theinsideshine/simply-supported-beam/docs/simply_supported_beam_BOM_v1.01.pdf

### BOM agrupado por nombre de pieza - solo piezas terminales

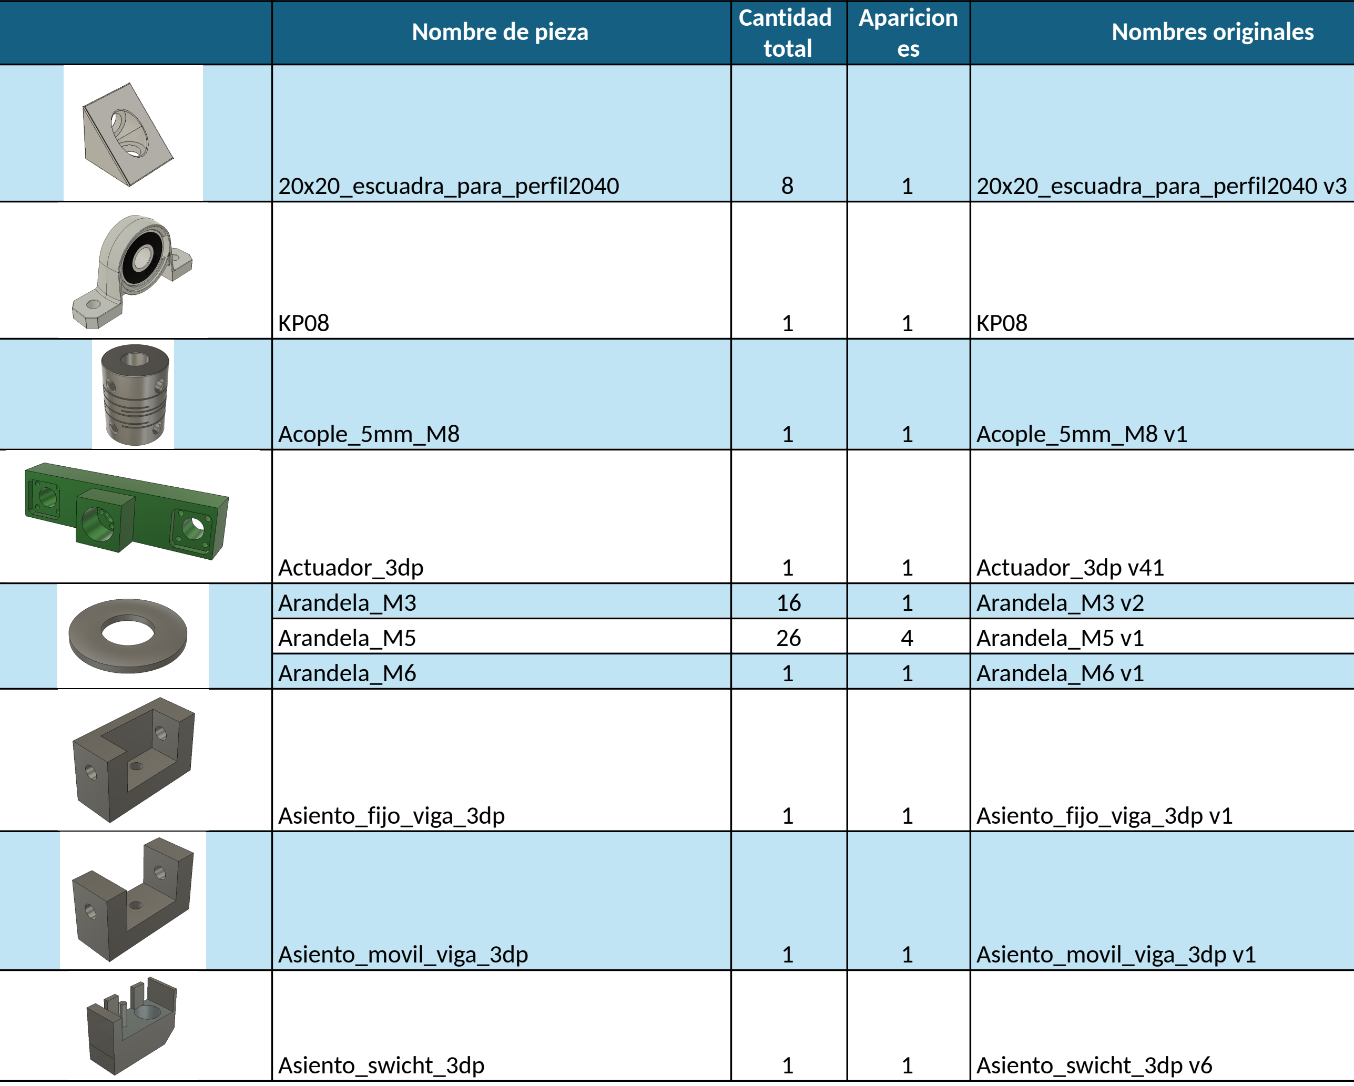
[picture p29: figure]
Nombre de pieza; Cantidad total; Aparicion es; Nombres originales; 20x20_escuadra_para_perfil2040; 20x20_escuadra_para_perfil2040 v3; Acople_5mm_M8; Acople_5mm_M8 v1; Actuador_3dp; Actuador_3dp v41; Arandela_M3; Arandela_M3 v2; Arandela_M5; Arandela_M5 v1; Arandela_M6; Arandela_M6 v1; Asiento_fijo_viga_3dp; Asiento_fijo_viga_3dp v1; Asiento_movil_viga_3dp; Asiento_movil_viga_3dp v1; Asiento_swicht_3dp; Asiento_swicht_3dp v6

Barra_thsl_M8_130mm-parteB | 1 | 1 | Barra_thsl_M8_130mm-parteB v1
Barra_thsl_M8_80mm-parteA | 1 | 1 | Barra_thsl_M8_80mm-parteA v1
Cama_pesas_3dp | 1 | 1 | Cama_pesas_3dp v4

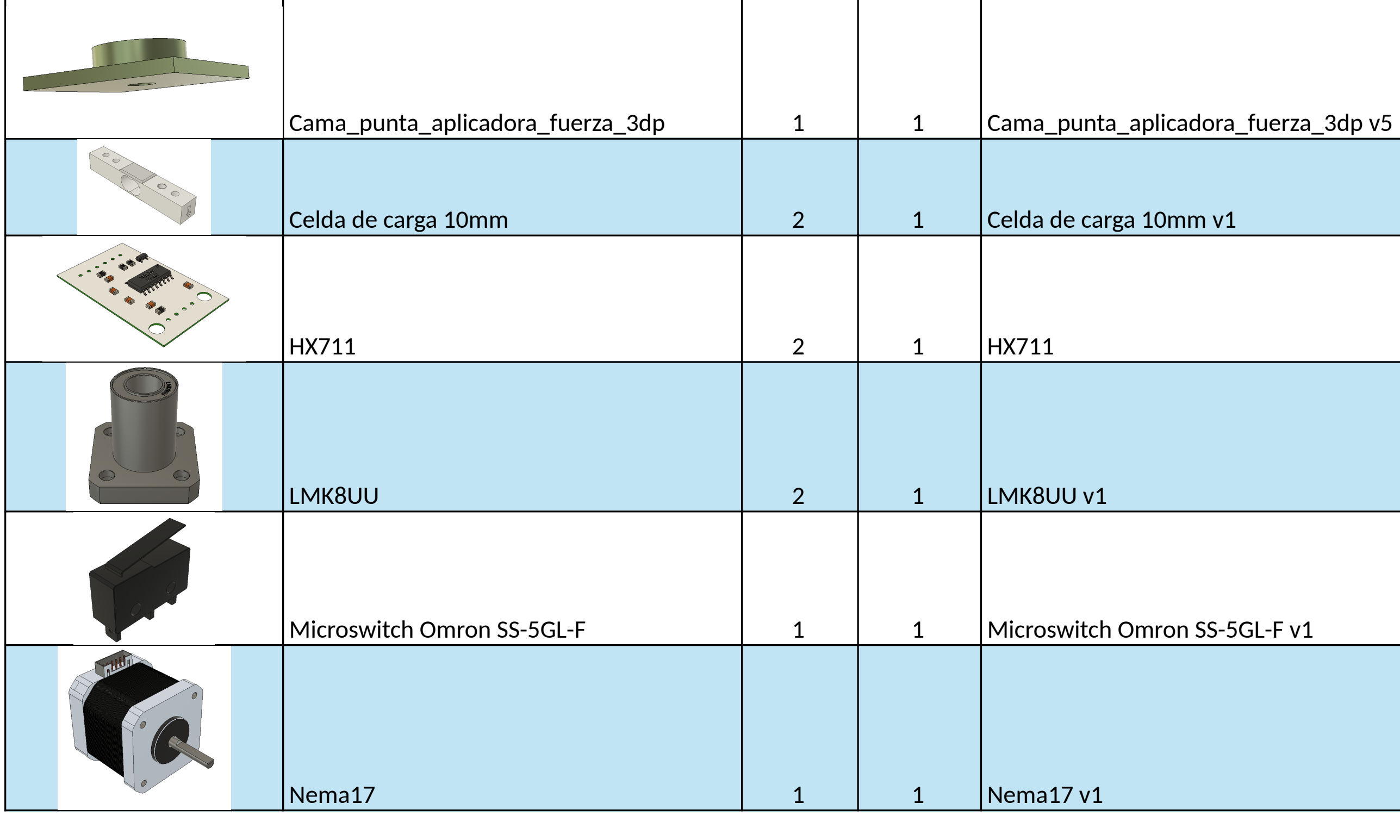
[picture p30: figure]
Cama_punta_aplicadora_fuerza_3dp; Cama_punta_aplicadora_fuerza_3dp v5; Celda de carga 10mm; Celda de carga 10mm v1; LMK8UU; LMK8UU v1; Microswitch Omron SS-5GL-F; Microswitch Omron SS-5GL-F v1; Nema17; Nema17 v1

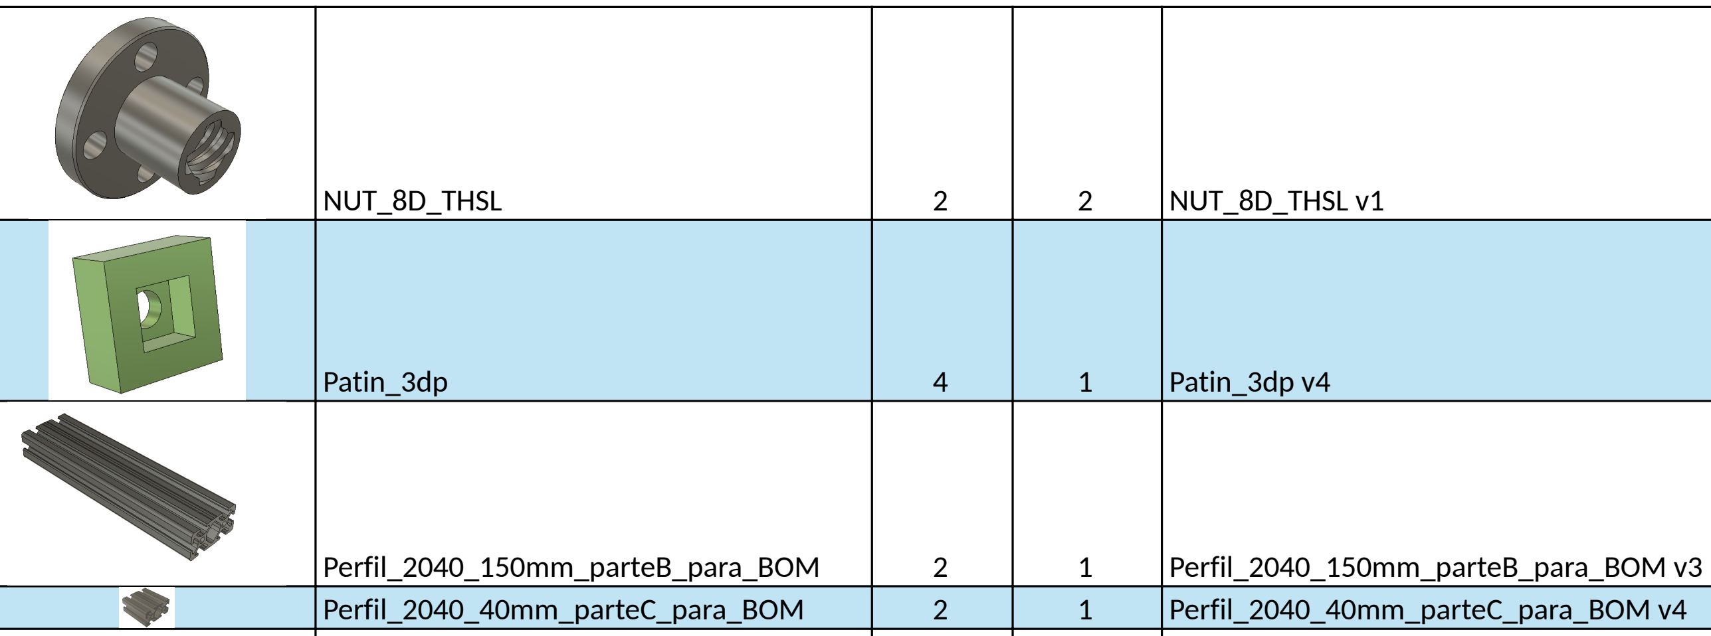
[picture p31: figure]
NUT_8D_THSL; NUT_8D_THSL v1; Patin_3dp; Patin_3dp v4; Perfil_2040_150mm_parteB_para_BOM; Perfil_2040_150mm_parteB_para_BOM v3; Perfil_2040_40mm_parteC_para_BOM; Perfil_2040_40mm_parteC_para_BOM v4
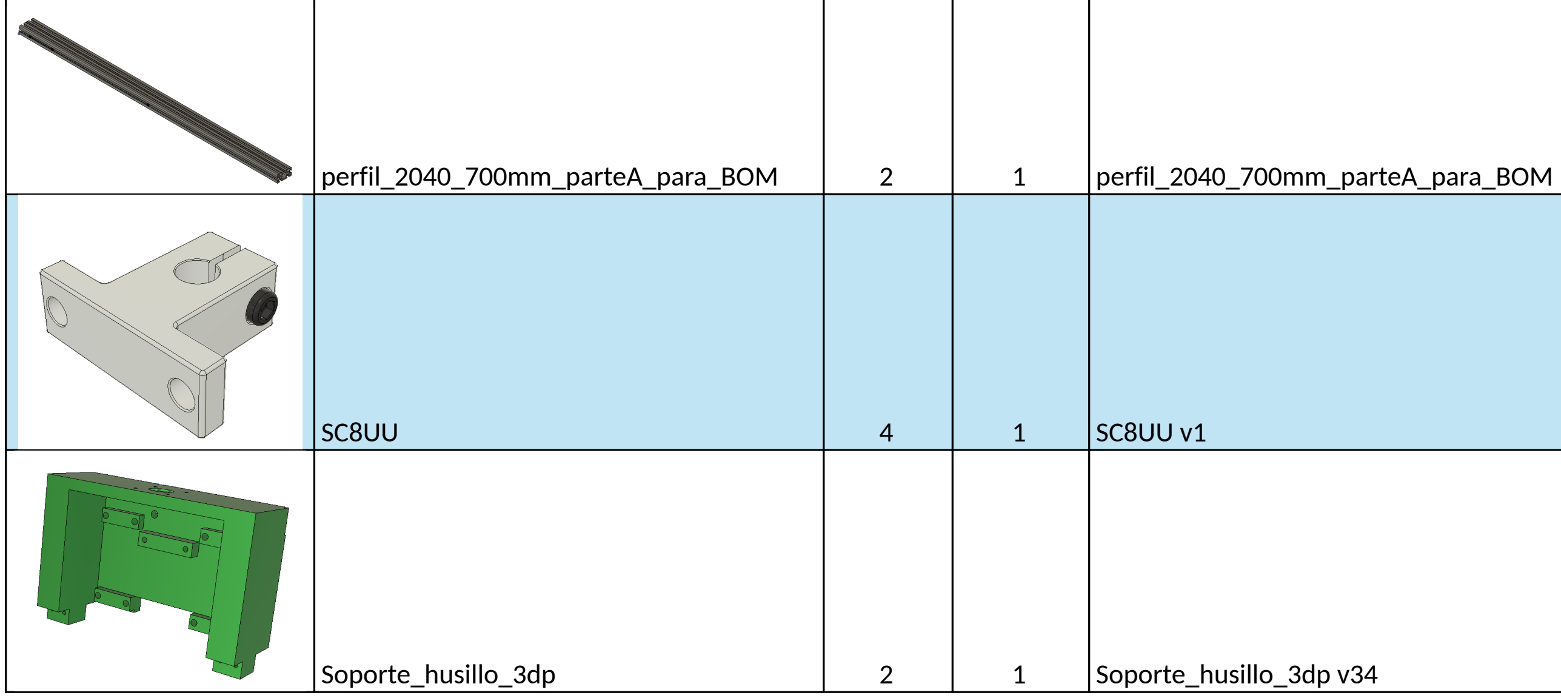
[picture p32: figure]
perfil_2040_700mm_parteA_para_BOM; Soporte_husillo_3dp; Soporte_husillo_3dp v34

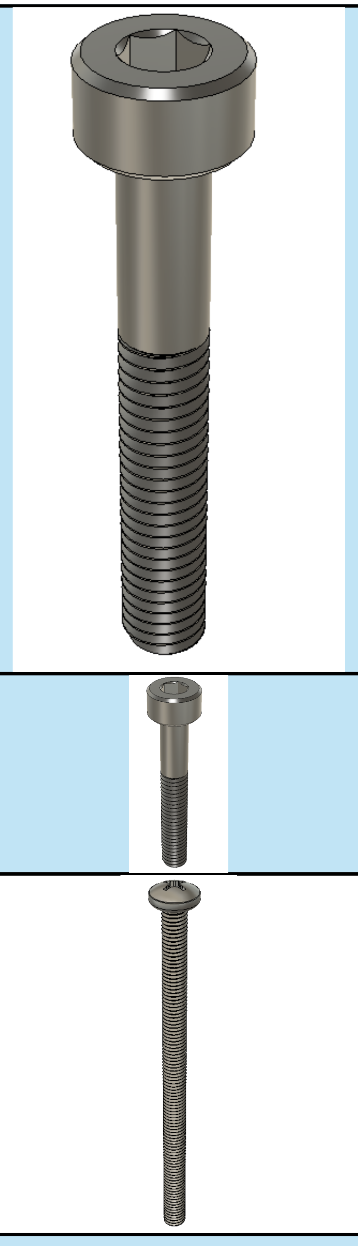
[picture p33: figure]

Tornillo_allen_M3_20mm | 4 | 1 | Tornillo_allen_M3_20mm v1
Tornillo_allen_M3_30mm | 12 | 1 | Tornillo_allen_M3_30mm v1
Tornillo_allen_M3_40mm | 8 | 1 | Tornillo_allen_M3_40mm v1
Tornillo_allen_M4_20mm | 2 | 1 | Tornillo_allen_M4_20mm v1
Tornillo_allen_M4_35mm | 1 | 1 | Tornillo_allen_M4_35mm v1
Tornillo_allen_M4_45mm | 1 | 1 | Tornillo_allen_M4_45mm v1
Tornillo_allen_M5_10mm | 20 | 2 | Tornillo_allen_M5_10mm v1
Tornillo_allen_M5_15mm | 2 | 2 | Tornillo_allen_M5_15mm v1
Tornillo_allen_M5_30mm | 16 | 1 | Tornillo_allen_M5_30mm v1
| Tornillo_allen_M5_50mm | 8 | 1 | Tornillo_allen_M5_50mm v1
| Tornillo_allen_M6_15mm | 1 | 1 | Tornillo_allen_M6_15mm v1
| Tornillo_allen_M6_55mm | 2 | 2 | Tornillo_allen_M6_55mm v1

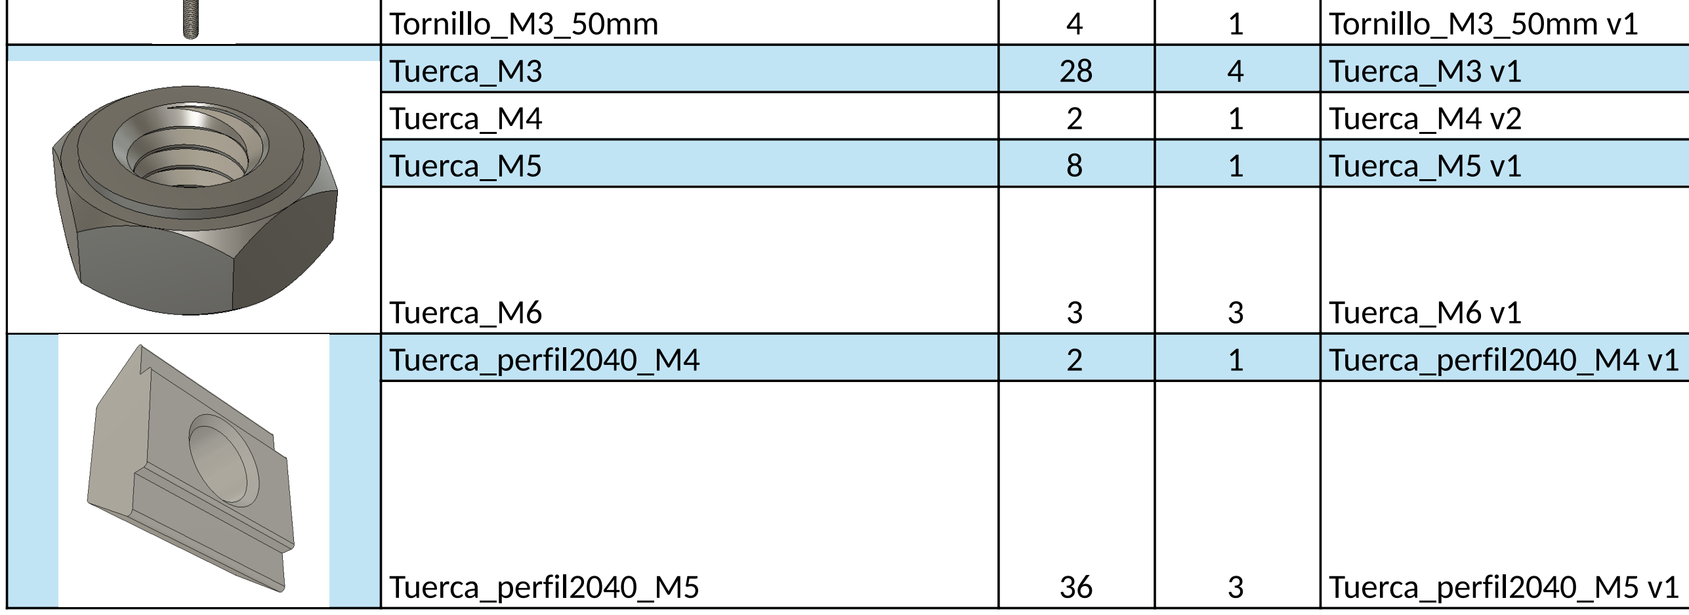
[picture p34: figure]
Tornillo_M3_50mm; Tornillo_M3_50mm v1; Tuerca_M3; Tuerca_M3 v1; Tuerca_M4; Tuerca_M4 v2; Tuerca_M5; Tuerca_M5 v1; Tuerca_M6; Tuerca_M6 v1; Tuerca_perfil2040_M4; Tuerca_perfil2040_M4 v1; Tuerca_perfil2040_M5; Tuerca_perfil2040_M5 v1

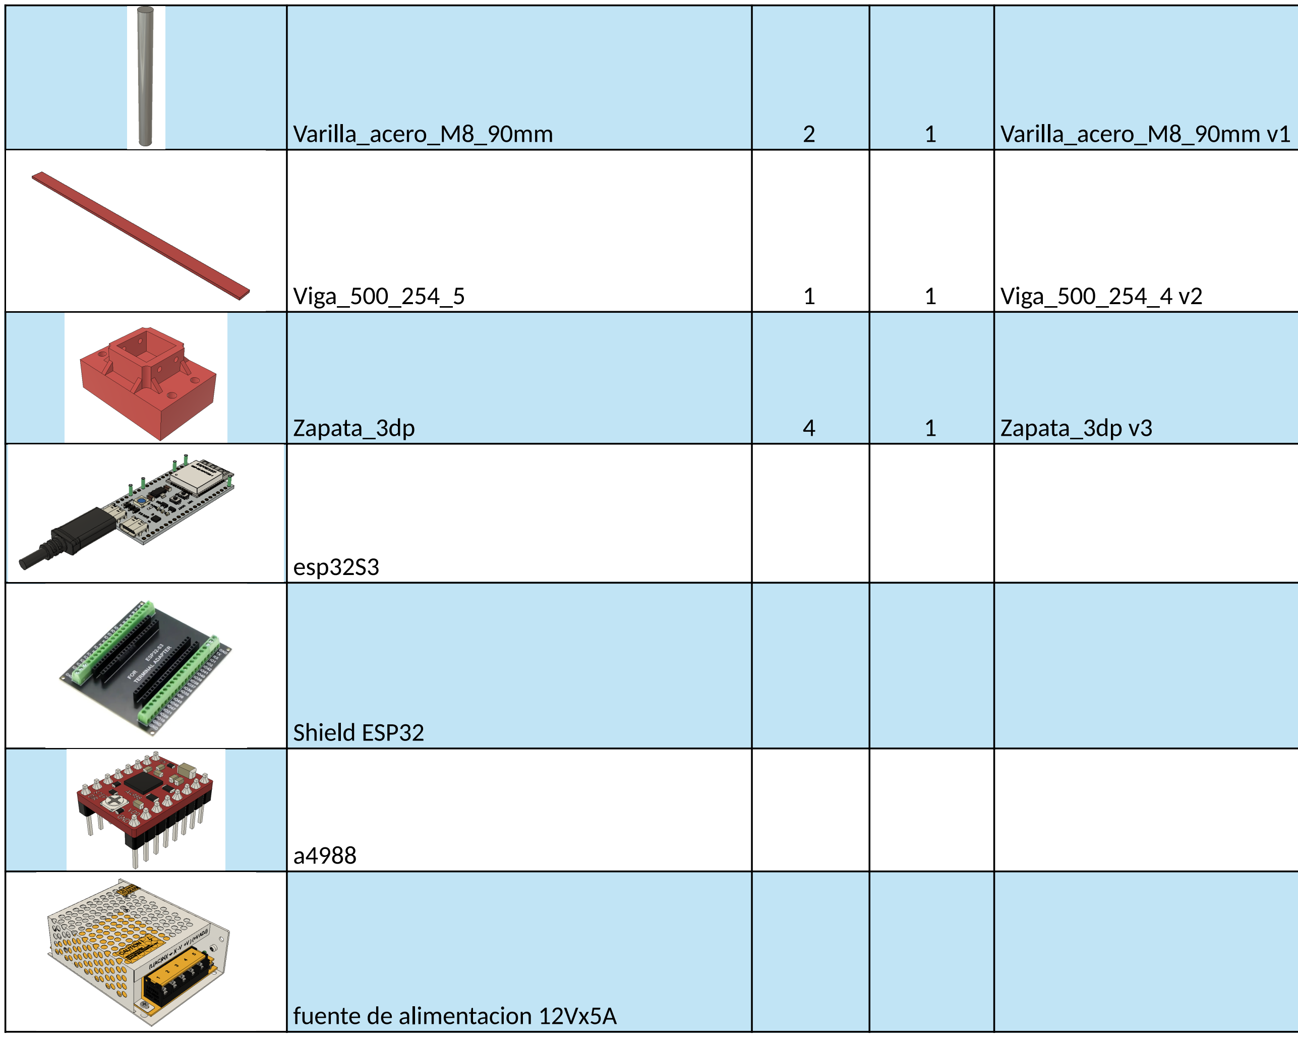
[picture p35: figure]
Varilla_acero_M8_90mm; Varilla_acero_M8_90mm v1; Viga_500_254_5; Viga_500_254_4 v2; Zapata_3dp; Zapata_3dp v3; esp32S3; Shield ESP32; fuente de alimentacion 12Vx5A
