theinsideshine/simply-supported-beam/docs/simply_supported_beam_sch_v1.00.pdf

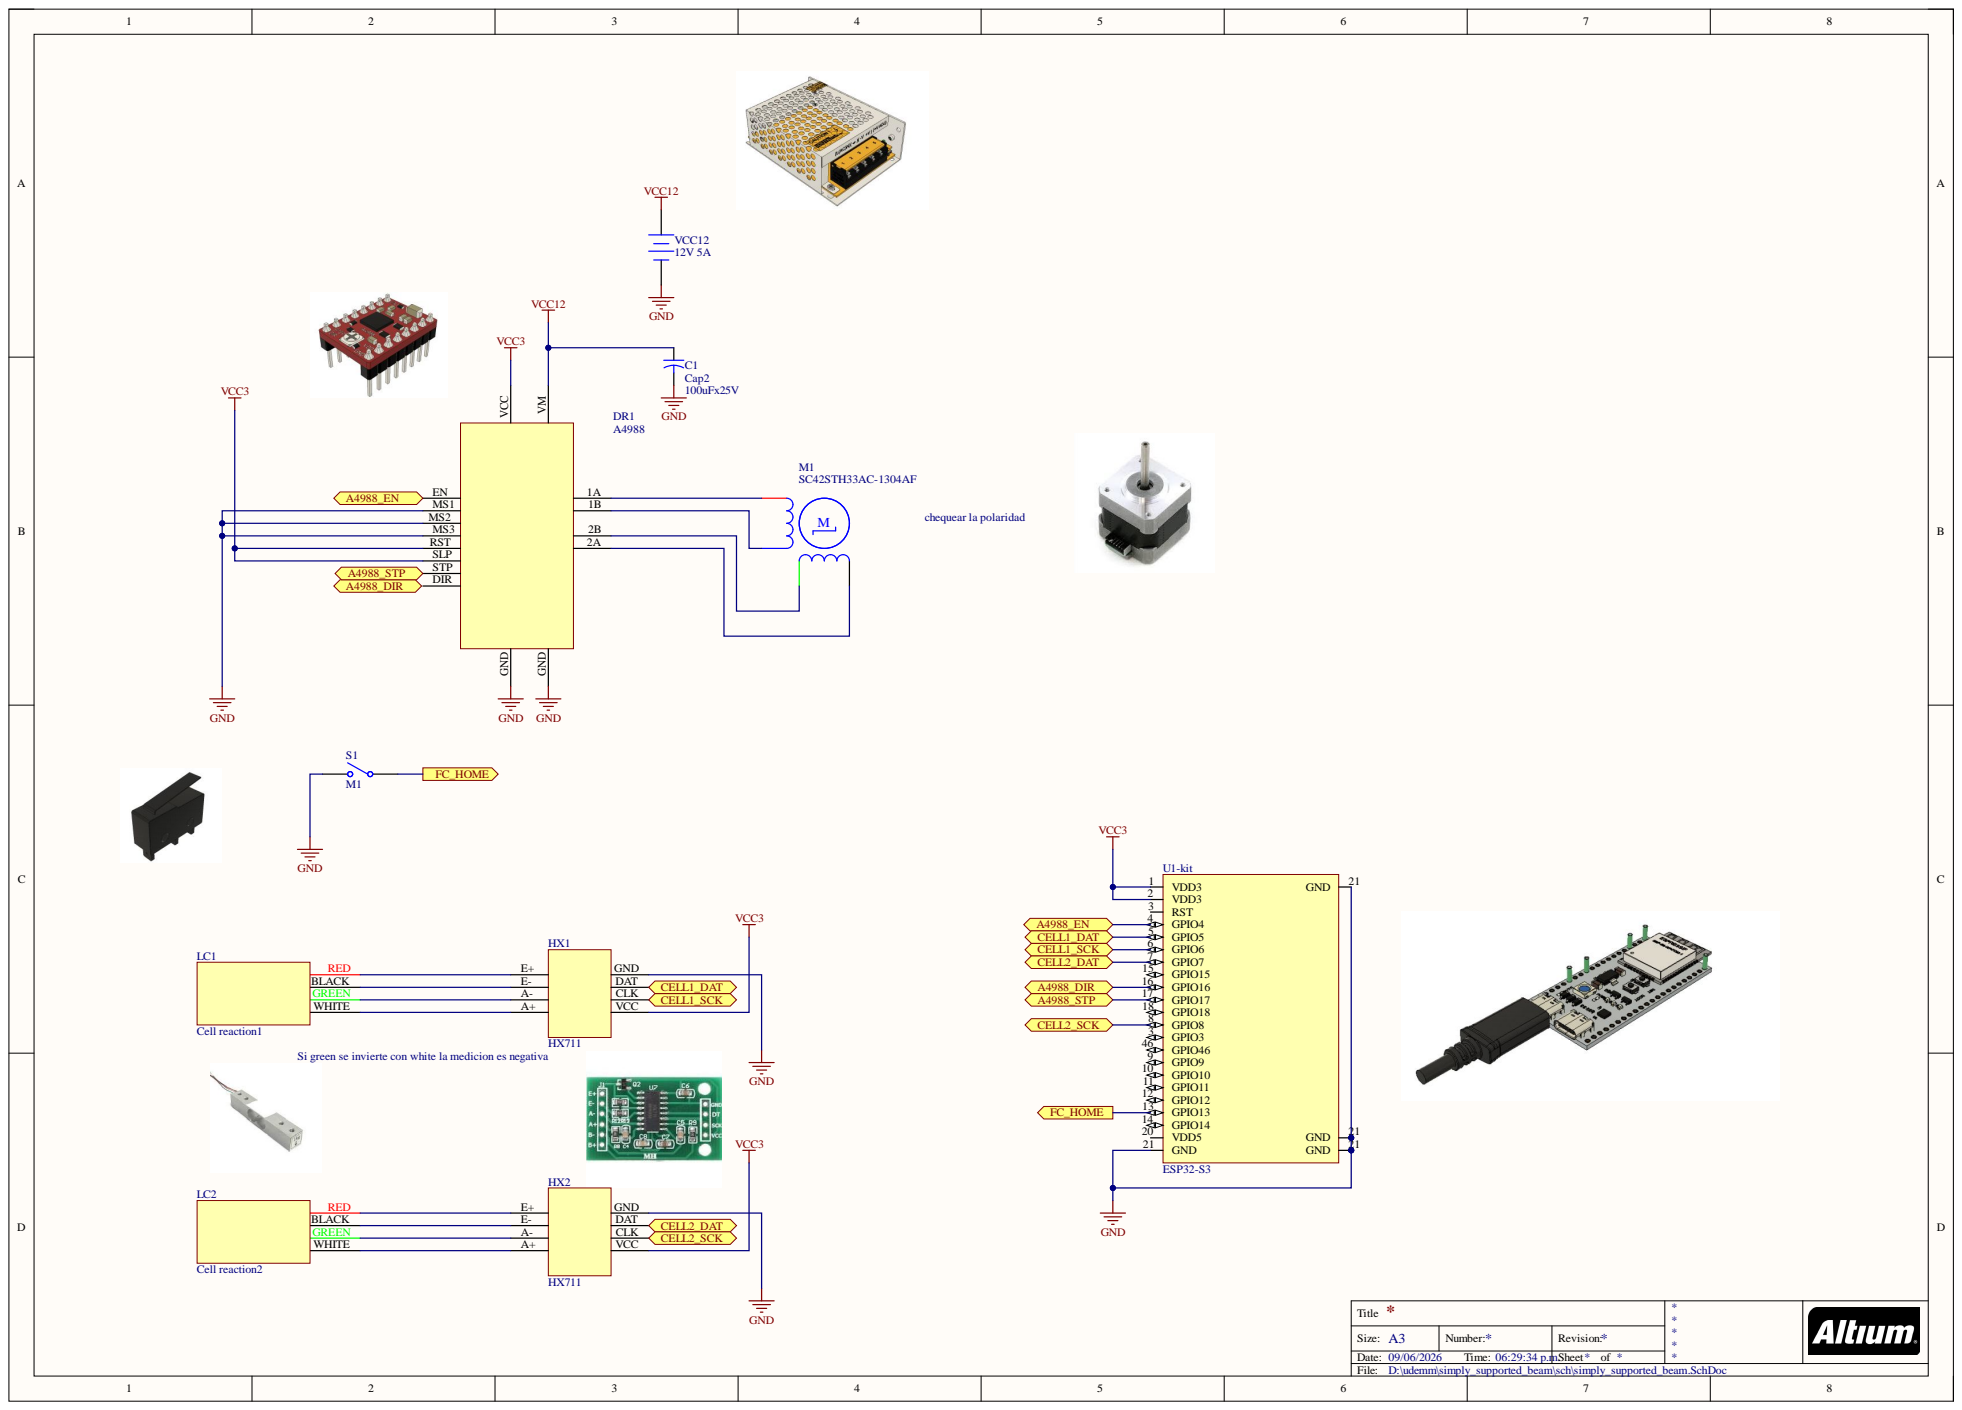
[picture p41: page 1]

MS2 | 2B
MS3
RST | 2A
SLP

Si green se invierte con white la medicion es negativa

BLACK E- | DAT | CELL2_DAT CELL2_SCK
GREEN A- | CLK
WHITE A+ | VCC
